anoujeremia/gametrak/images/IMG_0005.JPG

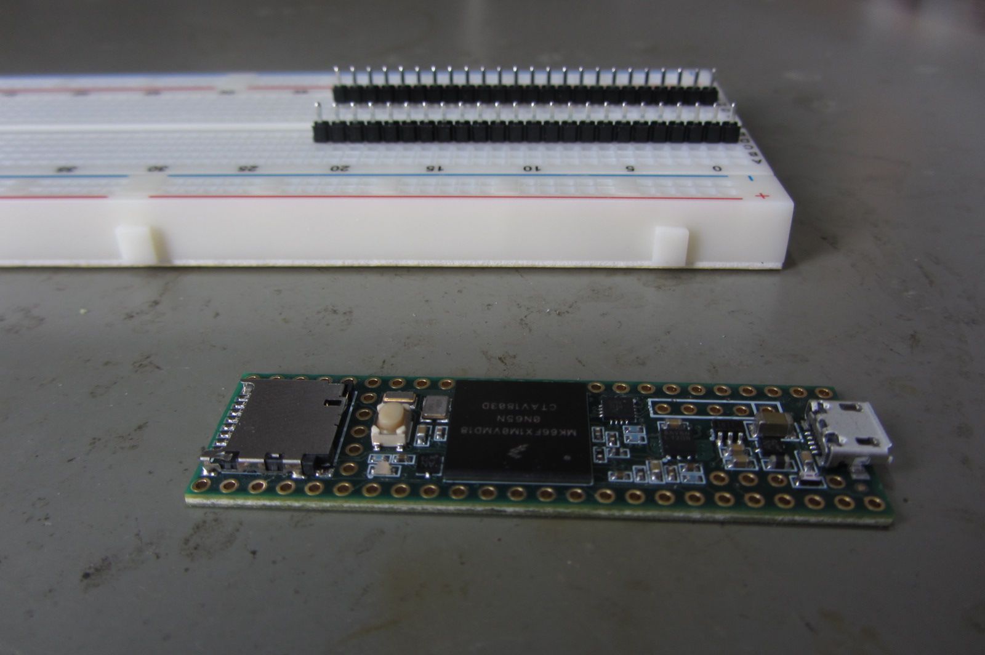
images/IMG_0005.JPG
