anoujeremia/gametrak/images/IMG_0008.JPG

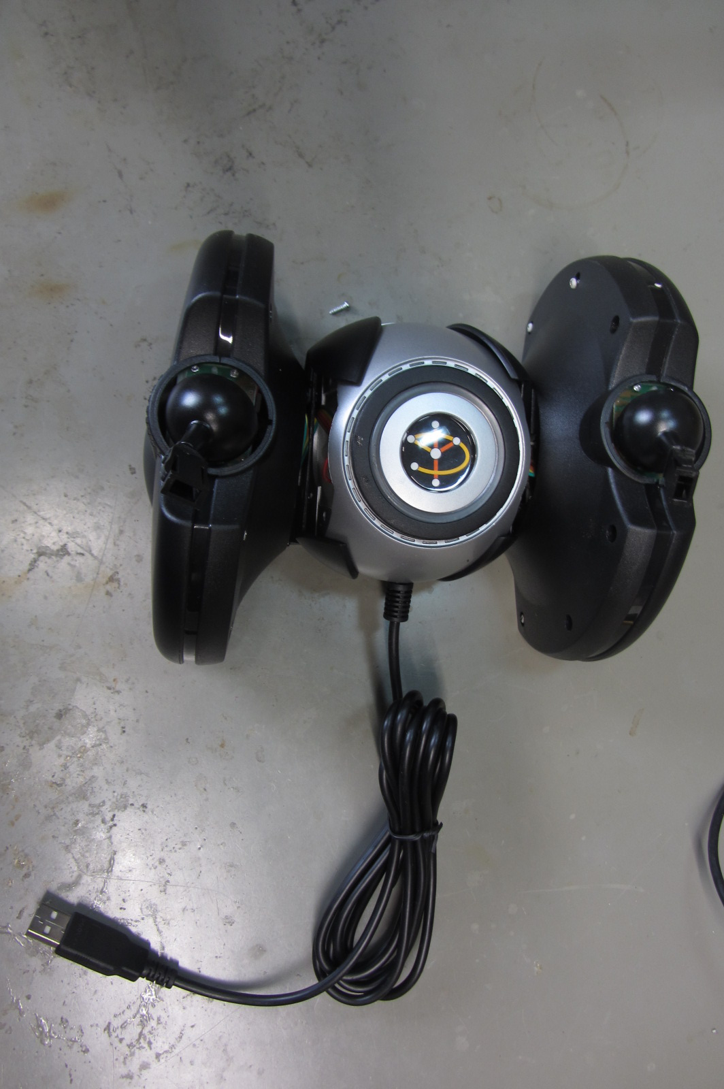
images/IMG_0008.JPG
