anoujeremia/gametrak/images/IMG_0011.JPG

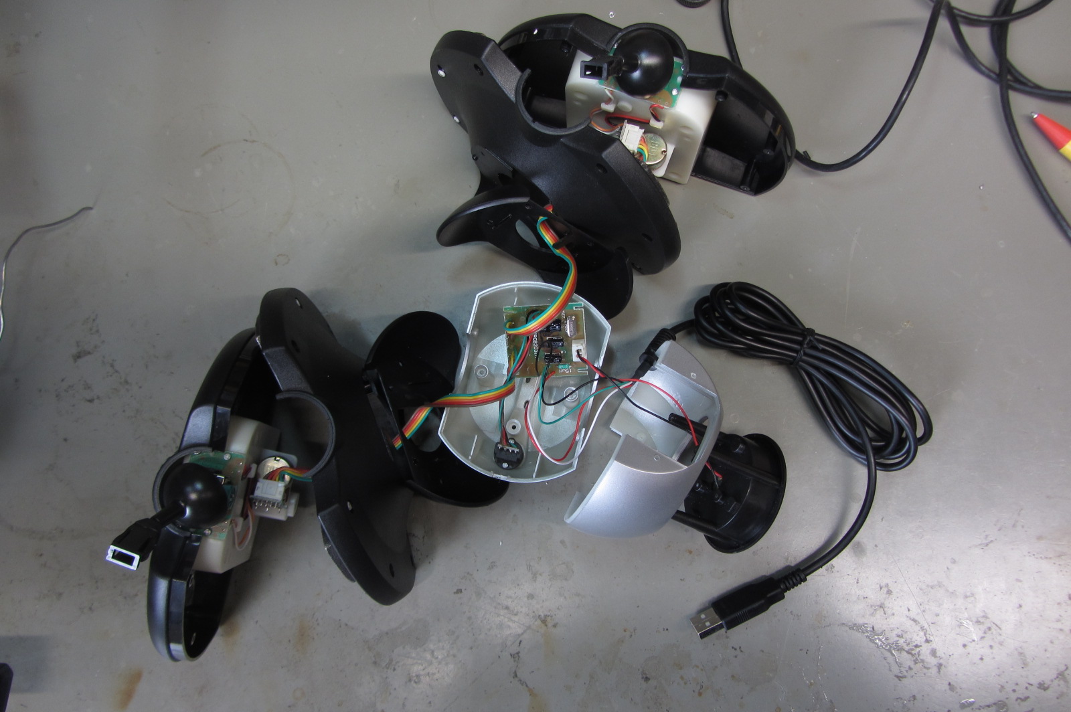
images/IMG_0011.JPG
