anoujeremia/gametrak/images/IMG_0014.JPG

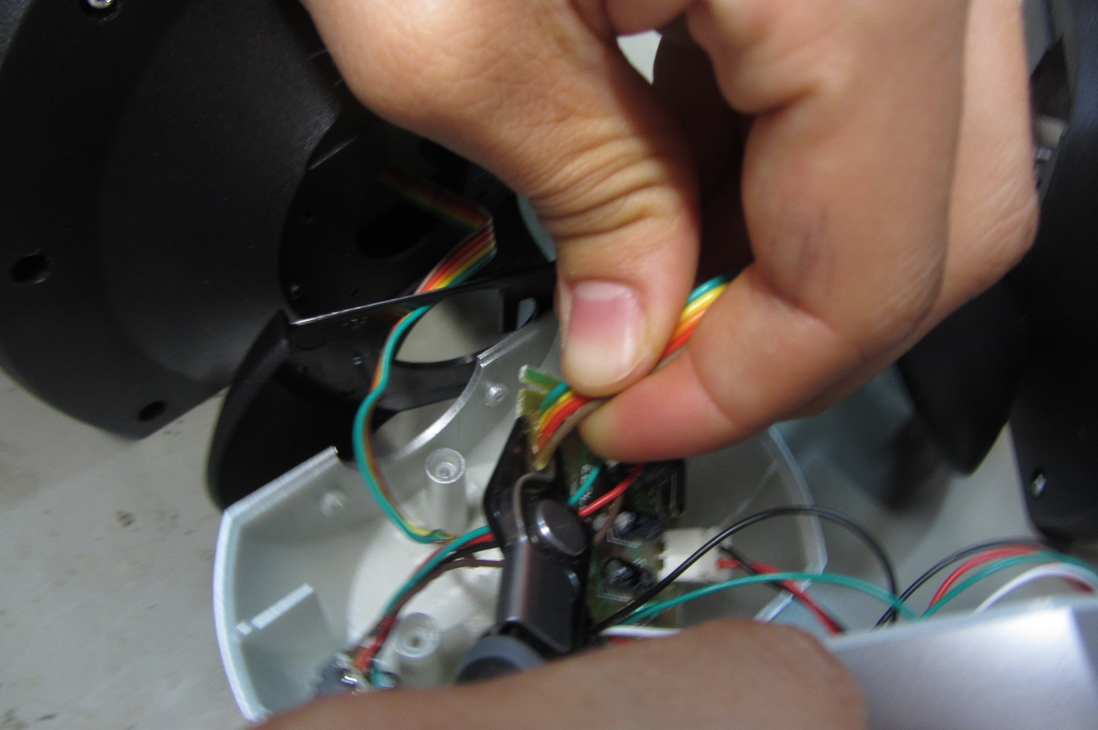
images/IMG_0014.JPG
