anoujeremia/gametrak/images/IMG_0017.JPG

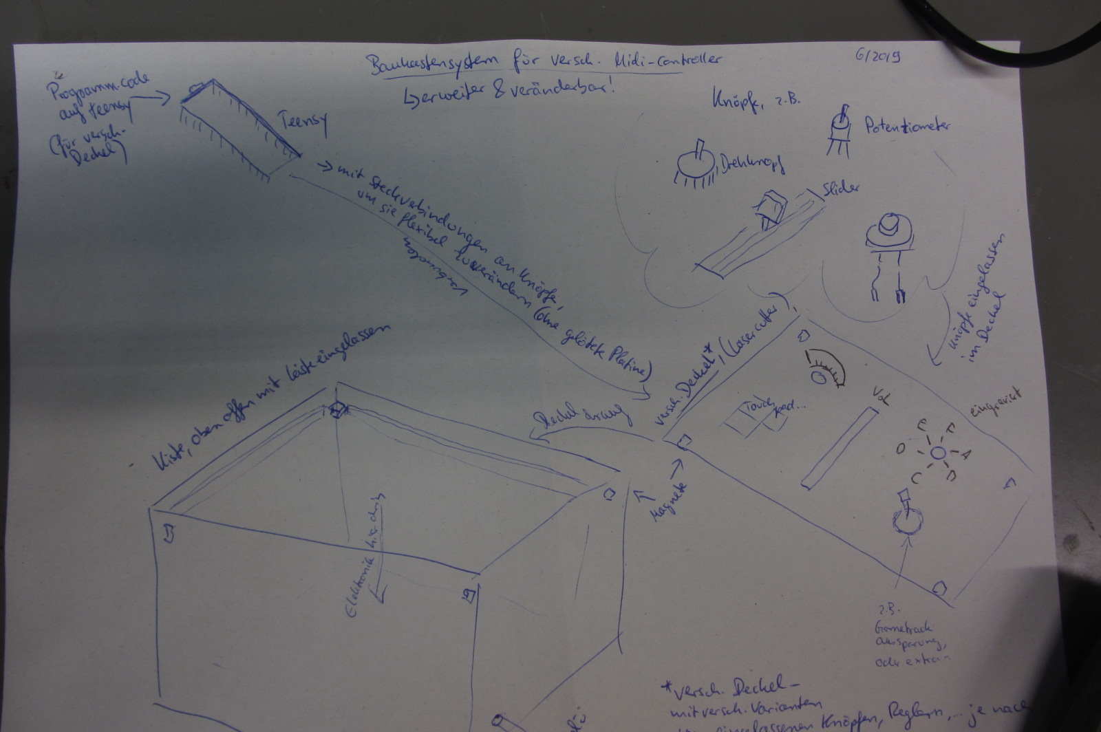
images/IMG_0017.JPG
