anoujeremia/gametrak/images/IMG_0018.JPG

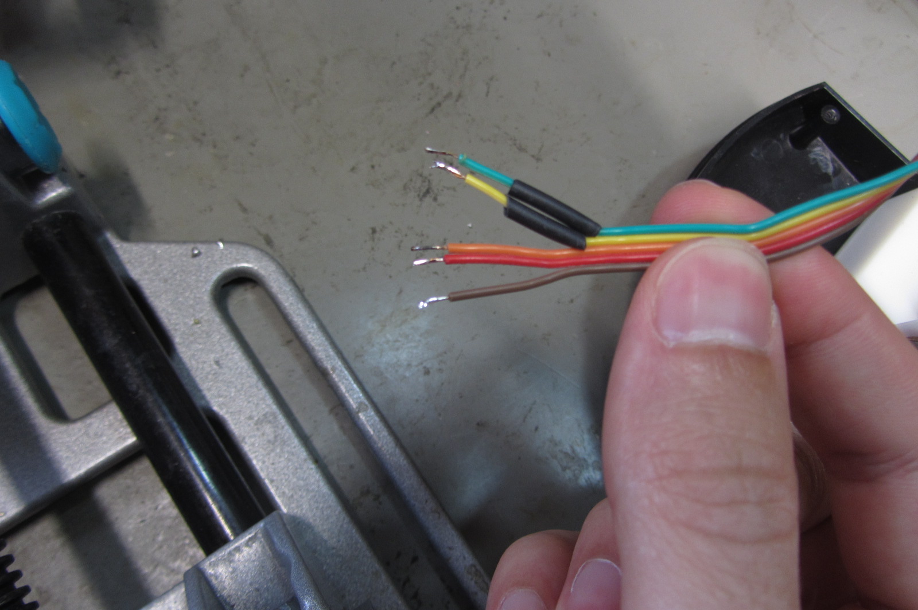
images/IMG_0018.JPG
