anoujeremia/gametrak/images/IMG_0028.JPG

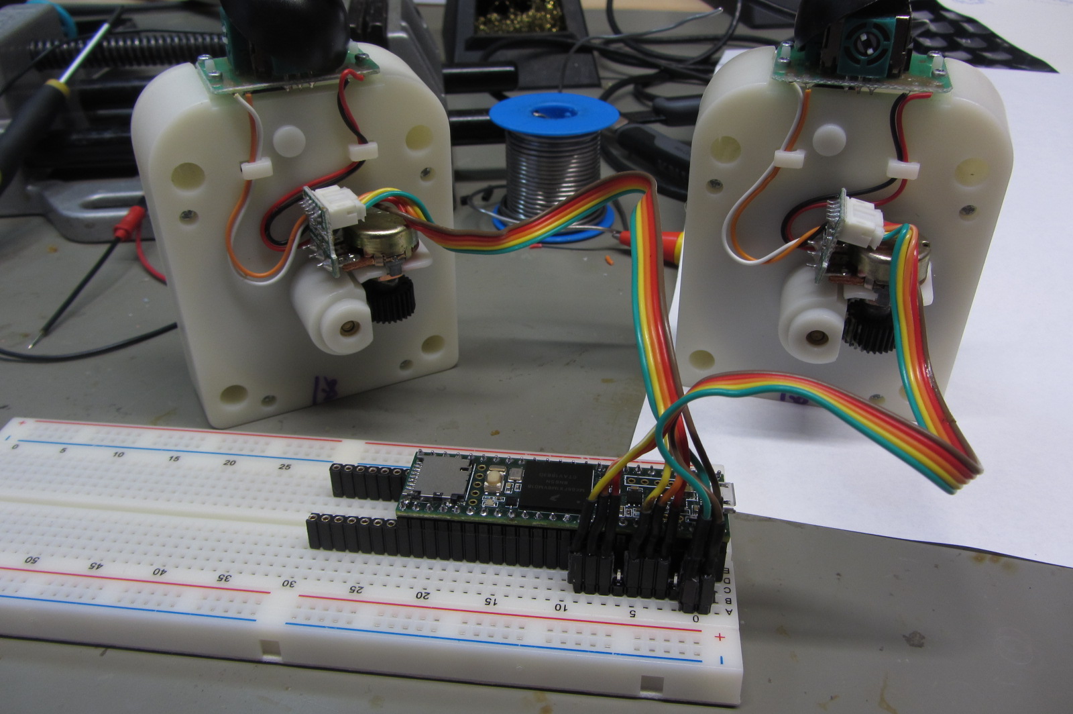
images/IMG_0028.JPG
