anoujeremia/gametrak/images/IMG_0032.JPG

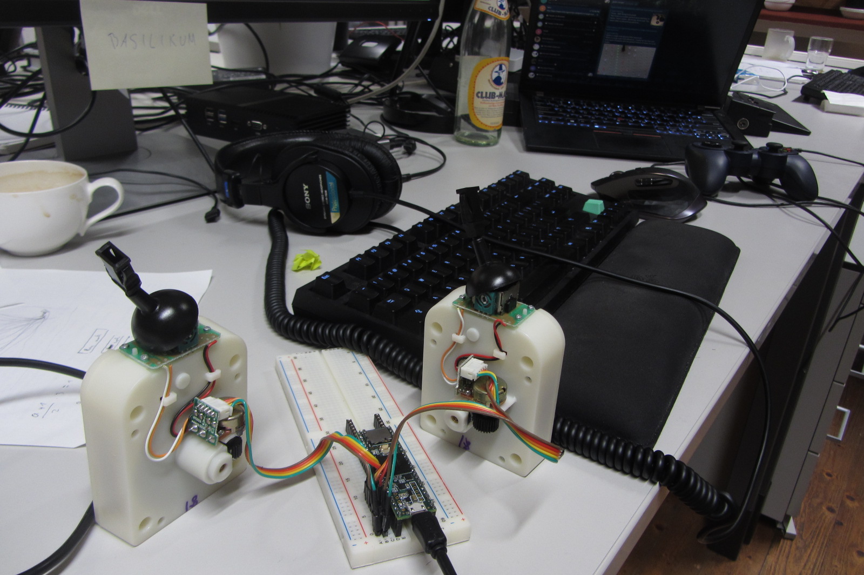
images/IMG_0032.JPG
