anoujeremia/gametrak/(commit log)

2019-09-01 Add source code for the teensy.
2019-09-20 teensy schaltplan eingefügt tabelle neu
2019-09-29 Neue formulierungen und detailliertere Anleitung zum Arduino
2019-09-29 Change USB MIDI device name to GameTrak
2019-09-29 Add instructions on calibration, and port setup.
